nathanshaw/Everthing-Board/README.md

# Everthing-Board
The Everything Board is an Arduino shield designed to avoid having to use a breadboard to mock up quick Arduino prototypes.
