nathanshaw/Everthing-Board/EAGLE files/shield-v3.brd

## EAGLE design EAGLE files/shield-v3.brd (2018-07-24)

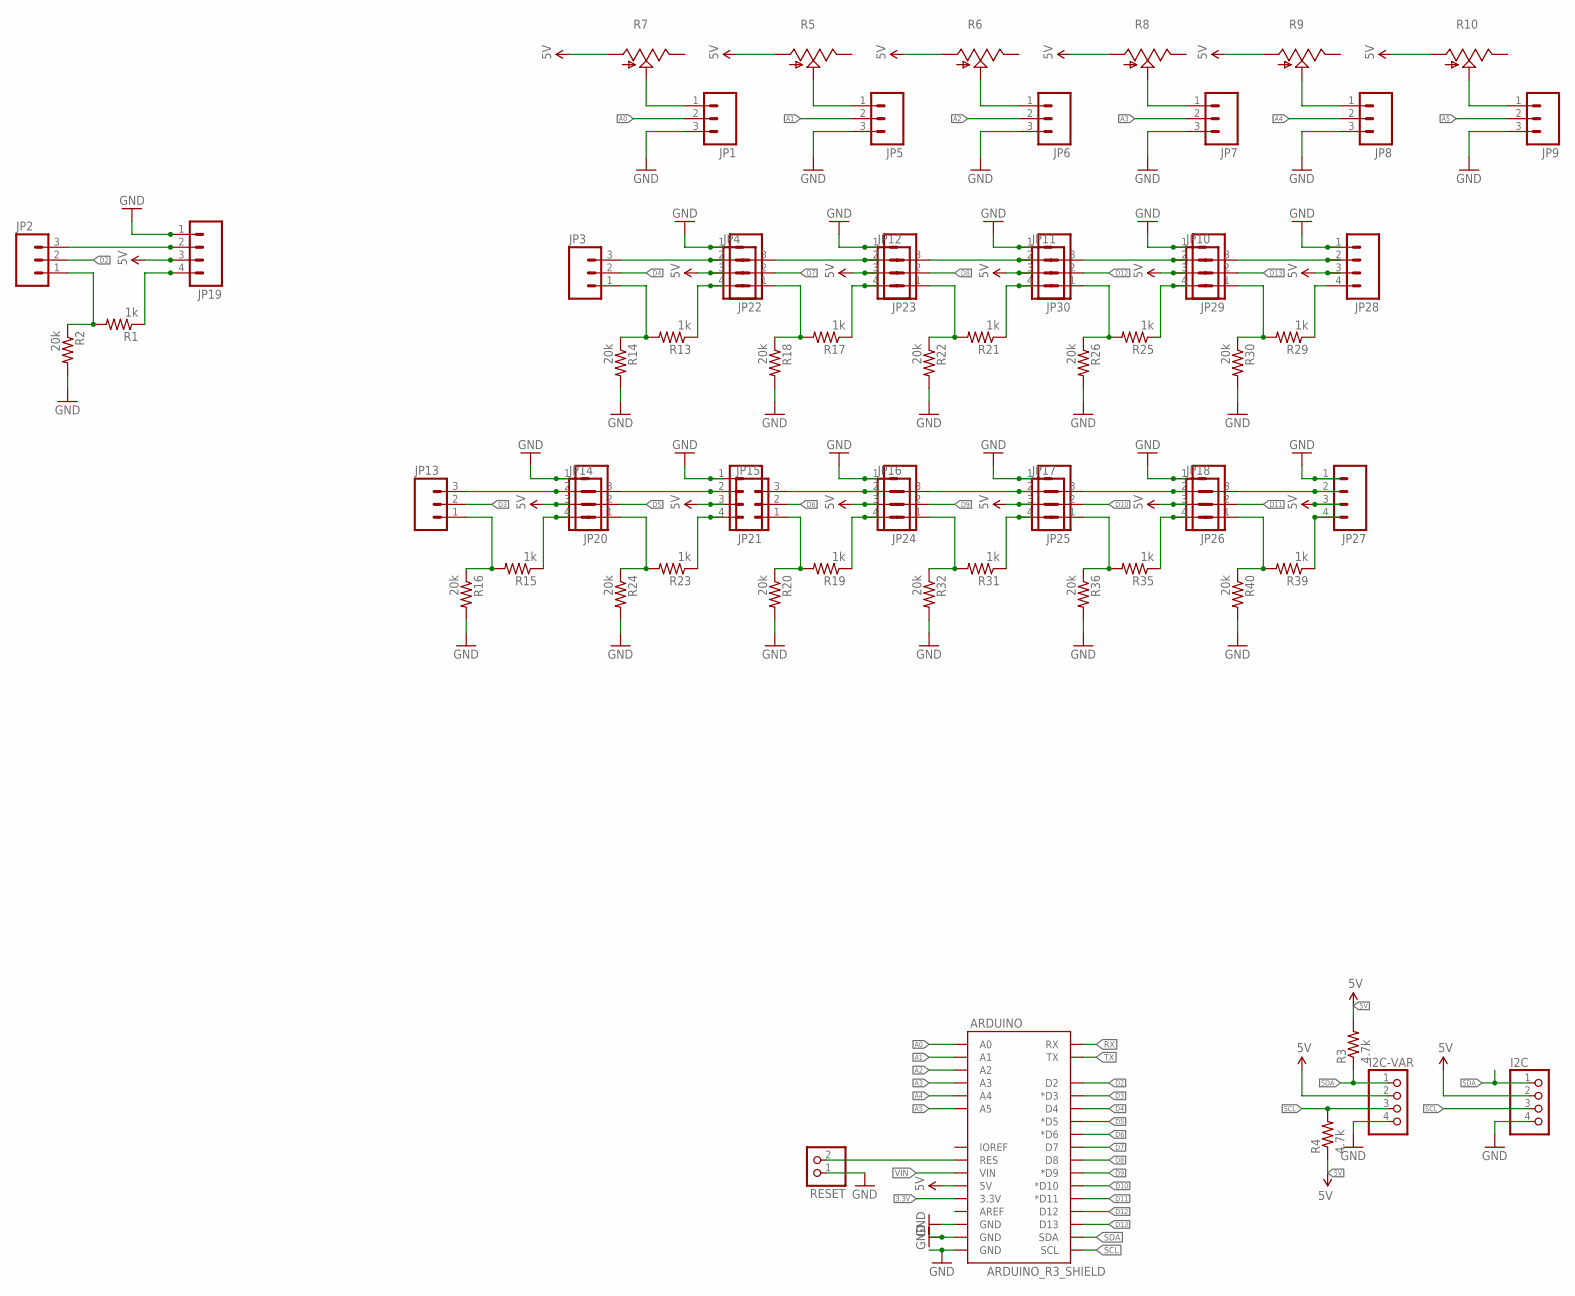
[picture p8: schematic shield-v3.sch]

Parts:
ARDUINO: ARDUINO_R3_SHIELD; UNO_R3_SHIELD
I2C, I2C-VAR: PINHD-1X4; 1X04
JP1, JP2, JP3, JP4, JP5, JP6, JP7, JP8, JP9, JP10, JP11, JP12, JP13, JP14, JP15, JP16, JP17, JP18: M03LOCK_NO_SILK; 1X03_LOCK_NO_SILK
JP19, JP20, JP21, JP22, JP23, JP24, JP25, JP26, JP27, JP28, JP29, JP30: M04LOCK; 1X04_LOCK
R1, R13, R15, R17, R19, R21, R23, R25, R29, R31, R35, R39: 1k; AXIAL-0.3-KIT
R2, R14, R16, R18, R20, R22, R24, R26, R30, R32, R36, R40: 20k; AXIAL-0.3-KIT
R3, R4: 4.7k; AXIAL-0.3-KIT
R5, R6, R7, R8, R9, R10: TRIM_US-CA6V; CA6V
RESET: PINHD-1X2; 1X02

Connections:
3.3V: ARDUINO.3.3V
5V: ARDUINO.5V, I2C.2, I2C-VAR.2, JP19.3, JP20.3, JP21.3, JP22.3, JP23.3, JP24.3, JP25.3, JP26.3, JP27.3, JP28.3, JP29.3, JP30.3, R3.P$2 (2), R4.P$1 (1), R5.A, R6.A, R7.A, R8.A, R9.A, R10.A
A0: ARDUINO.A0, JP1.2
A1: ARDUINO.A1, JP5.2
A2: ARDUINO.A2, JP6.2
A3: ARDUINO.A3, JP7.2
A4: ARDUINO.A4, JP8.2
A5: ARDUINO.A5, JP9.2
D2: ARDUINO.D2, JP2.2
D3: ARDUINO.D3 (*D3), JP13.2
D4: ARDUINO.D4, JP3.2
D5: ARDUINO.D5 (*D5), JP14.2
D6: ARDUINO.D6 (*D6), JP15.2
D7: ARDUINO.D7, JP4.2
D8: ARDUINO.D8, JP12.2
D9: ARDUINO.D9 (*D9), JP16.2
D10: ARDUINO.D10 (*D10), JP17.2
D11: ARDUINO.D11 (*D11), JP18.2
D12: ARDUINO.D12, JP11.2
D13: ARDUINO.D13, JP10.2
GND: ARDUINO.GND@0 (GND), ARDUINO.GND@1 (GND), ARDUINO.GND@2 (GND), I2C.4, I2C-VAR.4, JP1.3, JP5.3, JP6.3, JP7.3, JP8.3, JP9.3, JP19.1, JP20.1, JP21.1, JP22.1, JP23.1, JP24.1, JP25.1, JP26.1, JP27.1, JP28.1, JP29.1, JP30.1, R2.P$2 (2), R14.P$2 (2), R16.P$2 (2), R18.P$2 (2), R20.P$2 (2), R22.P$2 (2), R24.P$2 (2), R26.P$2 (2), R30.P$2 (2), R32.P$2 (2), R36.P$2 (2), R40.P$2 (2), RESET.1
unnamed: ARDUINO.RES, RESET.2
unnamed: JP1.1, R7.S
unnamed: JP5.1, R5.S
unnamed: JP6.1, R6.S
unnamed: JP7.1, R8.S
unnamed: JP8.1, R9.S
unnamed: JP9.1, R10.S
unnamed: JP19.4, R1.P$1 (1)
unnamed: JP2.3, JP19.2
unnamed: JP2.1, R1.P$2 (2), R2.P$1 (1)
unnamed: JP22.4, R13.P$1 (1)
unnamed: JP3.3, JP22.2
unnamed: JP3.1, R13.P$2 (2), R14.P$1 (1)
unnamed: JP20.4, R15.P$1 (1)
unnamed: JP13.3, JP20.2
unnamed: JP13.1, R15.P$2 (2), R16.P$1 (1)
unnamed: JP23.4, R17.P$1 (1)
unnamed: JP4.3, JP23.2
unnamed: JP4.1, R17.P$2 (2), R18.P$1 (1)
unnamed: JP24.4, R19.P$1 (1)
unnamed: JP15.3, JP24.2
unnamed: JP15.1, R19.P$2 (2), R20.P$1 (1)
unnamed: JP30.4, R21.P$1 (1)
unnamed: JP12.3, JP30.2
unnamed: JP12.1, R21.P$2 (2), R22.P$1 (1)
unnamed: JP21.4, R23.P$1 (1)
unnamed: JP14.3, JP21.2
unnamed: JP14.1, R23.P$2 (2), R24.P$1 (1)
unnamed: JP29.4, R25.P$1 (1)
unnamed: JP11.3, JP29.2
unnamed: JP11.1, R25.P$2 (2), R26.P$1 (1)
unnamed: JP28.4, R29.P$1 (1)
unnamed: JP10.3, JP28.2
unnamed: JP10.1, R29.P$2 (2), R30.P$1 (1)
unnamed: JP25.4, R31.P$1 (1)
unnamed: JP16.3, JP25.2
unnamed: JP16.1, R31.P$2 (2), R32.P$1 (1)
unnamed: JP26.4, R35.P$1 (1)
unnamed: JP17.3, JP26.2
unnamed: JP17.1, R35.P$2 (2), R36.P$1 (1)
unnamed: JP27.4, R39.P$1 (1)
unnamed: JP18.3, JP27.2
unnamed: JP18.1, R39.P$2 (2), R40.P$1 (1)
RX: ARDUINO.RX
SCL: ARDUINO.SCL, I2C.3, I2C-VAR.3, R4.P$2 (2)
SDA: ARDUINO.SDA, I2C.1, I2C-VAR.1, R3.P$1 (1)
TX: ARDUINO.TX
VIN: ARDUINO.VIN

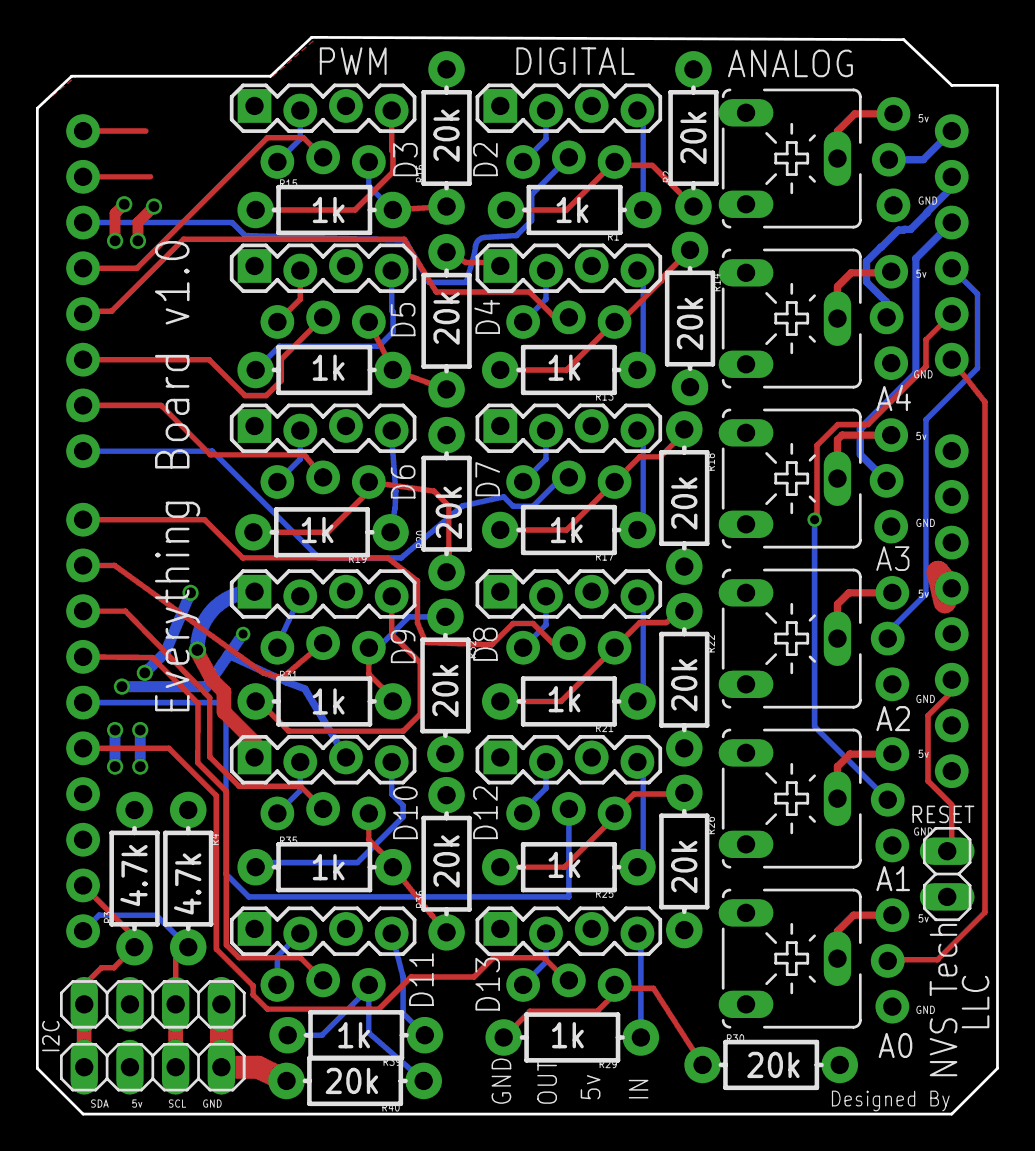
[picture p9: board shield-v3.brd from above]

Board: 2 copper layers, 53.3 x 59.8 mm, 66 parts (0 on the bottom side), 65 nets.
